abhirathkoushik-cub/ESP32-Solar-BT-Speaker/README.md

# ESP32-Solar-BT-Speaker
This Repository contains the Files and Code for our Pulse Solar Bluetooth Speaker built from a custom 2-layer PCB.
