abhirathkoushik-cub/ESP32-Solar-BT-Speaker/LPEDT_Pulse_FINAL_BOM.xlsx

Comment | Description | Designator | LibRef | Quantity
10uF 25V | Ceramic Capacitor, Ceramic, 25V, 10% +Tol, 10% -Tol, X5R, 15% TC, 10uF, Surface Mount, 0805 | C1, C4, C5, C6, C8, C9, C10, C12, C13, C14, C15, C16, C19, C20, C36 | GRM21BR61E106KA73K | 15 | DONE
0.1 uF 50V | 0.10uF Tol.1%. Rated voltage 50Vdc 125C SMD capacitor C0G(EIA) with capacitance | C2, C3, C7, C11, C26, C27, C29, C31, C33, C34, C35, C39 | GCM31C5C1H104FA16L | 12 | DONE
47nF 16V | CAPACITOR CERAMIC 0.047UF 16V, X7R, 10%, | C17, C21, C37 | CC0603KRX7R7BB473 | 3 | DONE
4.7 uF 25V | Ceramic capacitor SMD 0603 4.7 µF 25 V 10 % (L x W x H) 1.6 x 0.8 x 0.8 mm Murata GRM188R61E475KE11D 4000 pc(s) | C18, C30, C32 | GRM188R61E475KE11D | 3 | DONE
22 uF 16V | 22 µF ±20% 16V Ceramic Capacitor X5R 0603 (1608 Metric) | C22, C23, C24, C25, C28 | CL10A226MO7JZNC | 5 | DONE
1nF 16V | 1000pF ±10% 16V Ceramic Capacitor X7R 0603 (1608 Metric) | C38 | CC0603KRX7R7BB102 | 1 | DONE
SP0503BAHTG | SP050xBA Series 8.5 V 30 pF Triple Uni-Directional TVS Avalanche Diode-SOT143-4 | D1 | SP0503BAHTG | 1
5V ESD |  | D2, D3, D6 | WE-TVS_DFN1610-2L_824032815 | 3 | DONE
6V 2A | No Description Available | F1 | 0ZCJ0200FF2C | 1 | DONE
0.1" M Header | CONN HEADER VERT 2POS 2.54MM | H1, H2, H3, H4, H5 | PRPC002SAAN-RC | 5 | DONE
micro-USB | 10118194-0001LF micro-USB paste-in-pad | J1 | USB-Micro B | 1 | DONE
1uH 7.2A | 1 ÂµH Shielded Molded Inductor 7.2 A 15mOhm Max 1616 (4040 Metric) | L1 | WE-MAPI_4020 | 1 | DONE
1.5uH 9.1A | Description | L2 | ETQ-P3M1R5KVN | 1 | DONE
GRN 0603 | LED, 0603, GREEN, 430MCD, 520NM | LED1, LED2, LED3 | 150060GS75000 | 3 | DONE
SS8050-G | Description | Q1, Q2 | SS8050-G | 2 | DONE
634kΩ | Res Thick Film 0603 634K Ohm 1% 0.1W(1/10W) ±100ppm/C Pad SMD Automotive T/R | R1 | RMCF0603FT634K | 1 | DONE
0 | 0 Ohms Jumper 0.125W, 1/8W Chip Resistor 0603 (1608 Metric) Anti-Sulfur Thin Film | R2, R29, R30, R32, R33, R34, R37, R39, R40, R42, R43, R44 | MCT06030Z0000ZP500 | 12 | PARTIAL
127kΩ | RES 127K OHM 1% 1/10W 0603 | R3 | RMCF0603FT127K | 1 | DONE
100kΩ | RMCF Series 0603 0.1 W 100 kOhm Â±5 % Â±100 ppm/Â°C SMT Thick Film Chip Resistor | R4 | RMCF0603JT100K | 1 | DONE
100Ω | RES 100 OHM 0.1% 1/10W 0603 | R5 | RN73H1JTTD1000B25 | 1 | DONE
2.2kΩ | RES 2.2K OHM 1% 1/10W 0603 | R6, R17, R18 | RN73H1JTTD2201F50 | 3 | DONE
4.7kΩ | Res Thick Film 1.6 x 0.8 mm 4.7K Ohm 1% 0.1W(1/10W) 100ppm/ C Molded SMD Paper T/R | R7, R9 | RC0603FR-074K7L | 2 | DONE
5.23kΩ | 5.23 kOhms ±1% 0.1W, 1/10W Chip Resistor 0603 (1608 Metric) Moisture Resistant Thick Film | R8 | RC0603FR-075K23L | 1 | DONE
10k | 10 kOhms Â±1% 0.125W, 1/8W Chip Resistor 0603 (1608 Metric) Anti-Sulfur, Moisture Resistant Thin Film | R10 | RNCP0603FTD10K0 | 1 | DONE
30.9kΩ | 30,9K 1% 0,1W RC0603 | R11 | RC0603FR-0730K9L | 1 | DONE
1MΩ | 1 MOhms ±5% 0.1W, 1/10W Chip Resistor 0603 (1608 Metric) Automotive AEC-Q200 Thick Film | R12, R13 | RMCF0603JT1M00 | 2 | DONE
180kΩ | 180 kOhms ±1% 0.1W, 1/10W Chip Resistor 0603 (1608 Metric) Automotive AEC-Q200 Thick Film | R14 | RMCF0603FT180K | 1 | DONE
10kΩ | 100mW Thick Film Resistors 75V ±100ppm/℃ ±1% 10kΩ 0603 Chip Resistor - Surface Mount ROHS | R15, R16, R22, R23, R24, R25 | RC0603FR-0710KL | 6 | DONE
1kΩ | Res Thick Film 0603 1K Ohm 1% 0.1W(1/10W) ±100ppm/C Pad SMD T/R Automotive AEC-Q200 | R19 | RMCF0603FT1K00 | 1 | DONE
22.1kΩ | Res Thick Film 0603 22.1K Ohm 1% 0.1W(1/10W) ±100ppm/C Pad SMD Automotive T/R | R20 | RMCF0603FT22K1 | 1 | DONE
47.5kΩ | Res Thick Film 0603 47.5K Ohm 1% 0.1W(1/10W) ±100ppm/C Pad SMD T/R Automotive AEC-Q200 | R21 | RMCF0603FT47K5 | 1 | DONE
3k | 3k ohm | R31 | RMCF0603JT3K00 | 1 | DONE
 | SWITCH TACTILE SPST-NO 0.05A 24V | SW1, SW2, SW3 | 1825910-6 | 3 | DONE
MAX98357A Audio Amplifier | MAX98357A Series 5.5 V 3.2 W PCM Input Class D Audio Power Amplifier - TQFN-16 | U1 | MAX98357AETE+T | 1 | DONE
ESP32-WROOM-32E-N4 | WLAN+BT Module 2412MHz to 2484MHz 47-Pin SMD Module | U2 | ESP32-WROOM-32E-N4 | 1 | DONE
BQ25798RQMR | IÂ²C controlled, 1-4-cell, 5-A buck-boost solar battery charger with dual-input selector and MPPT | U3 | BQ25798RQMR | 1 | DONE
TPS63020DSJR | High Efficiency Single Inductor Buck-Boost Converter with 4A Switch | U4 | TPS63020DSJR | 1 | DONE
CP2102N-A02-GQFN28R | Interface IC full speed USB to UART bridge USB 2.0 3.3V, CP2102N-A02-GQFN24R, VFQFN-24 | U5 | CP2102N-A02-GQFN28R | 1 | DONE
