abhirathkoushik-cub/ESP32-Solar-BT-Speaker/LPEDT_Pulse_FINAL_SCHEMATICS.pdf

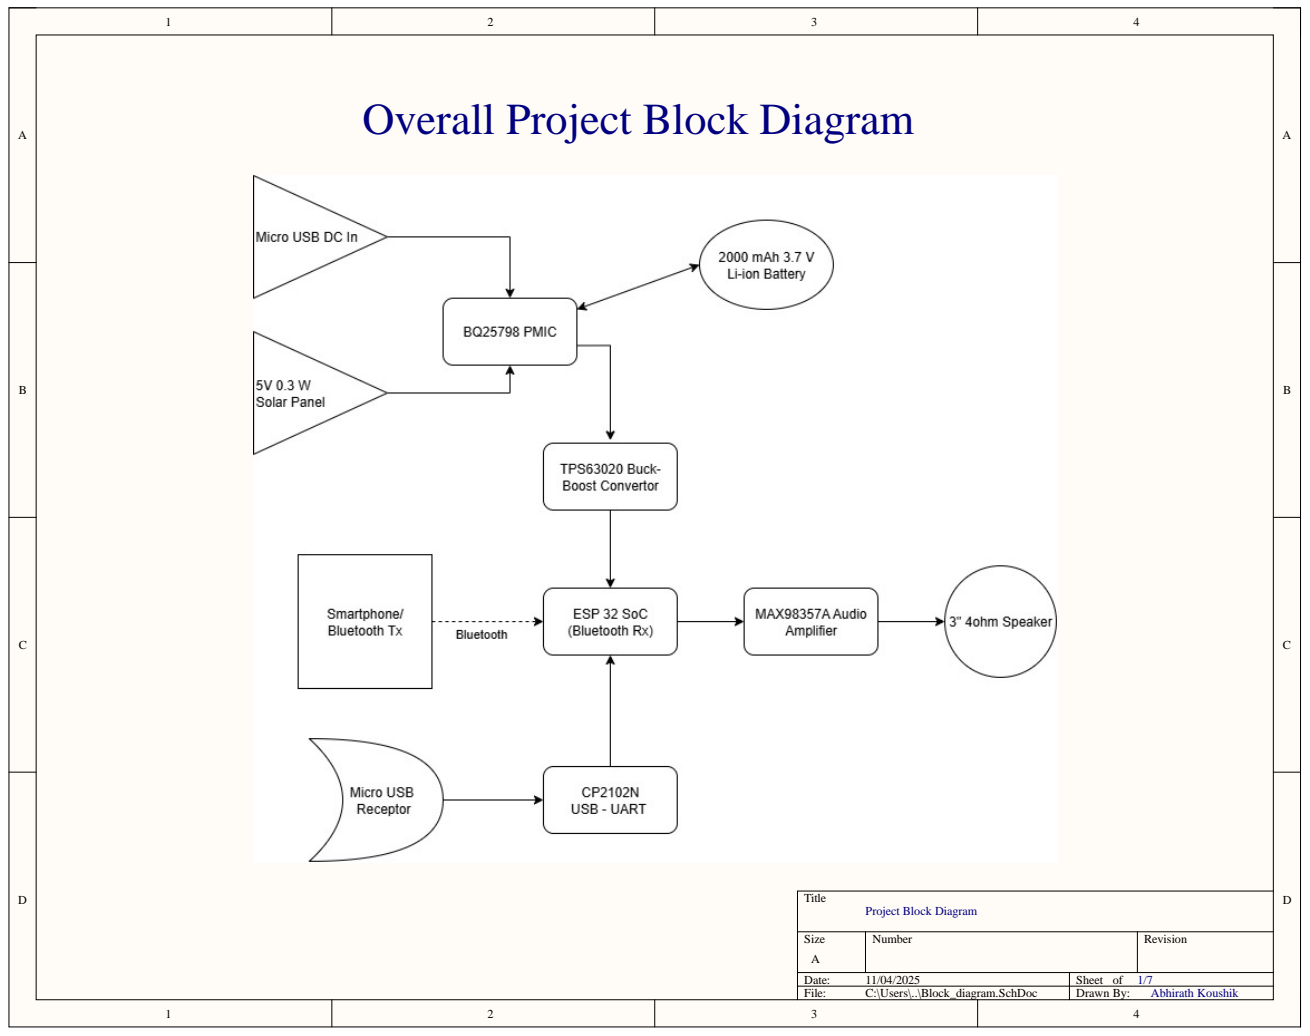
[picture p12: page 1]

Overall Project Block Diagram

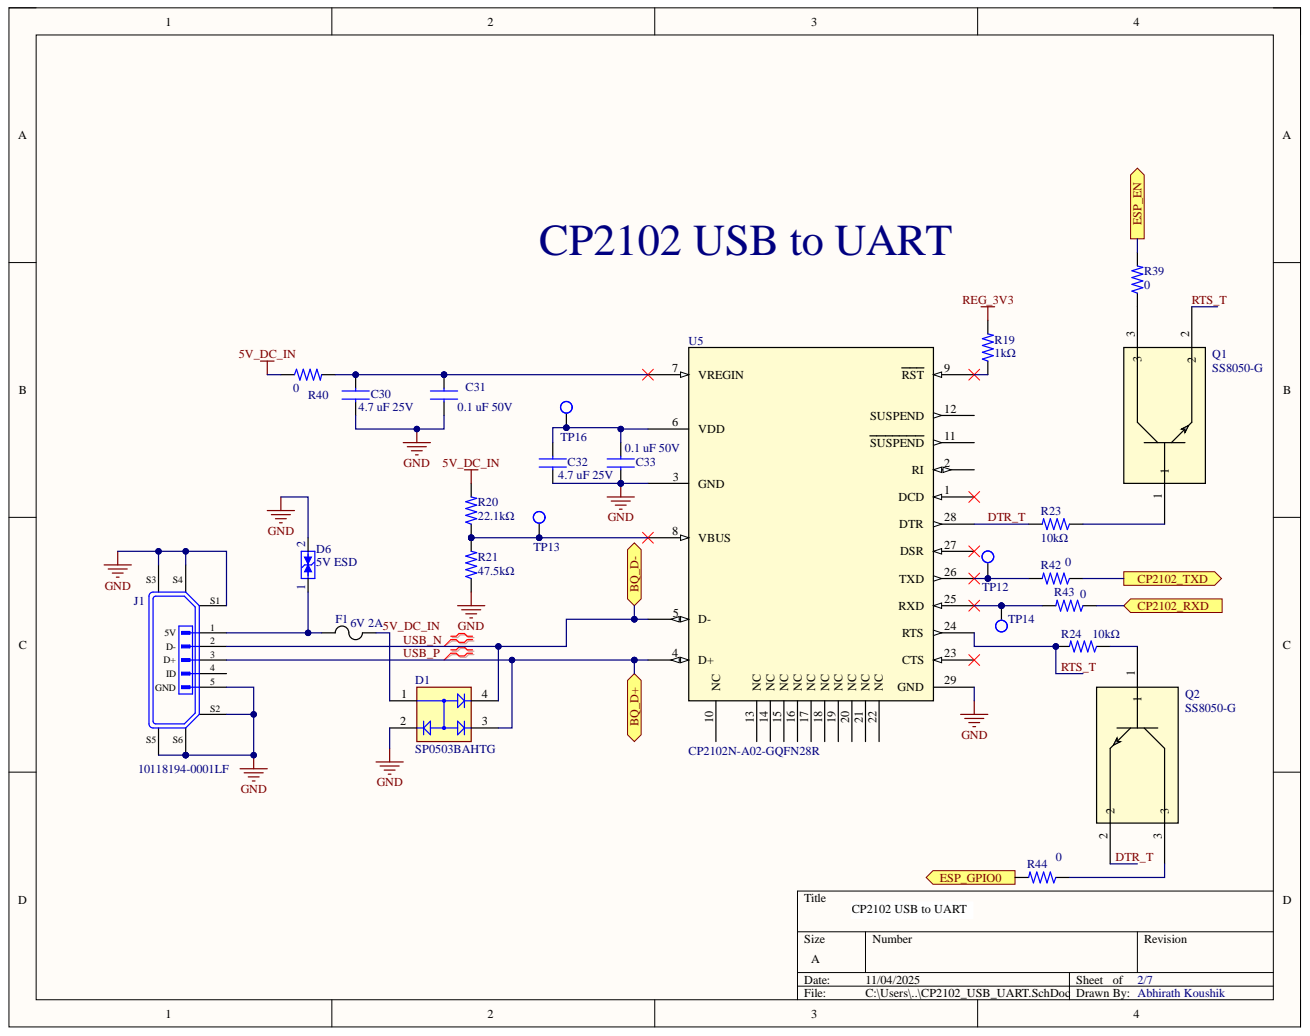
[picture p13: page 2]

4 | D 1

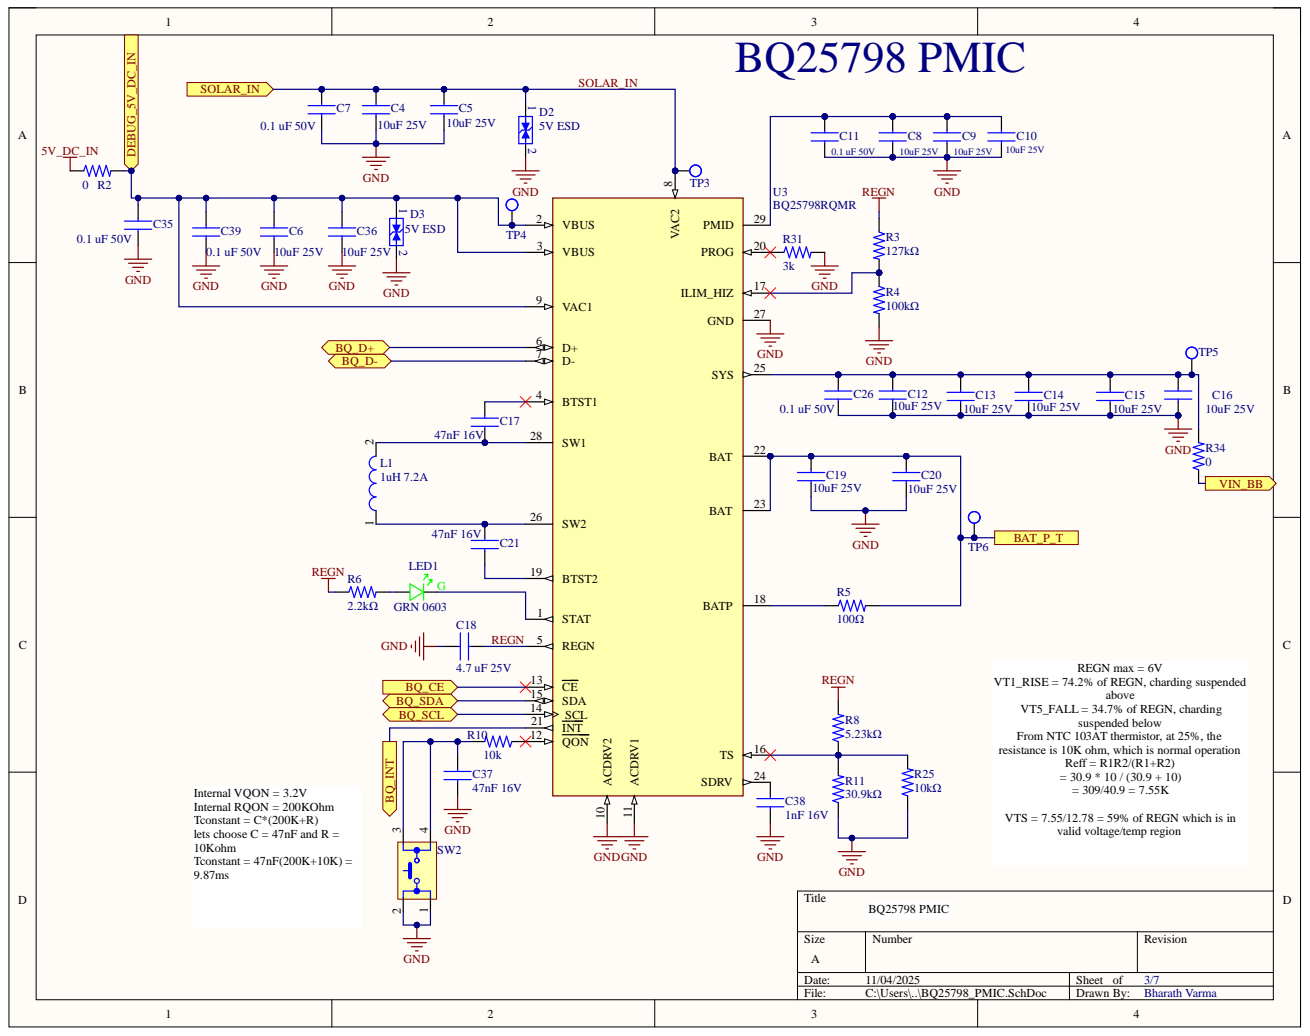
[picture p14: page 3]

VT1_RISE = 74.2% of REGN, charding suspended

From NTC 103AT thermistor, at 25%, the
resistance is 10K ohm, which is normal operation

VTS = 7.55/12.78 = 59% of REGN which is in

valid voltage/temp region

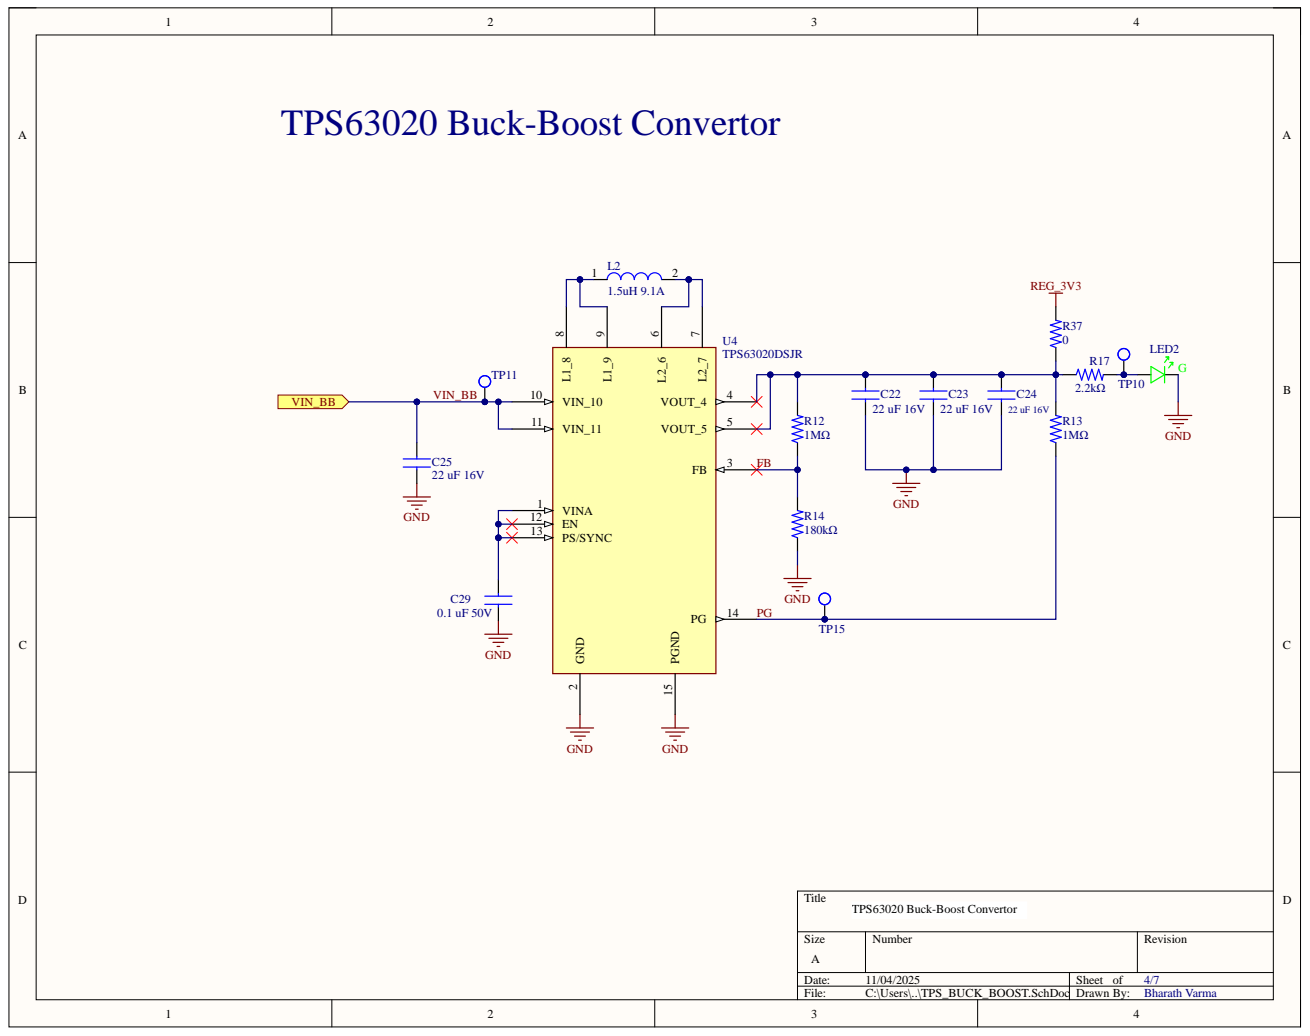
[picture p15: page 4]

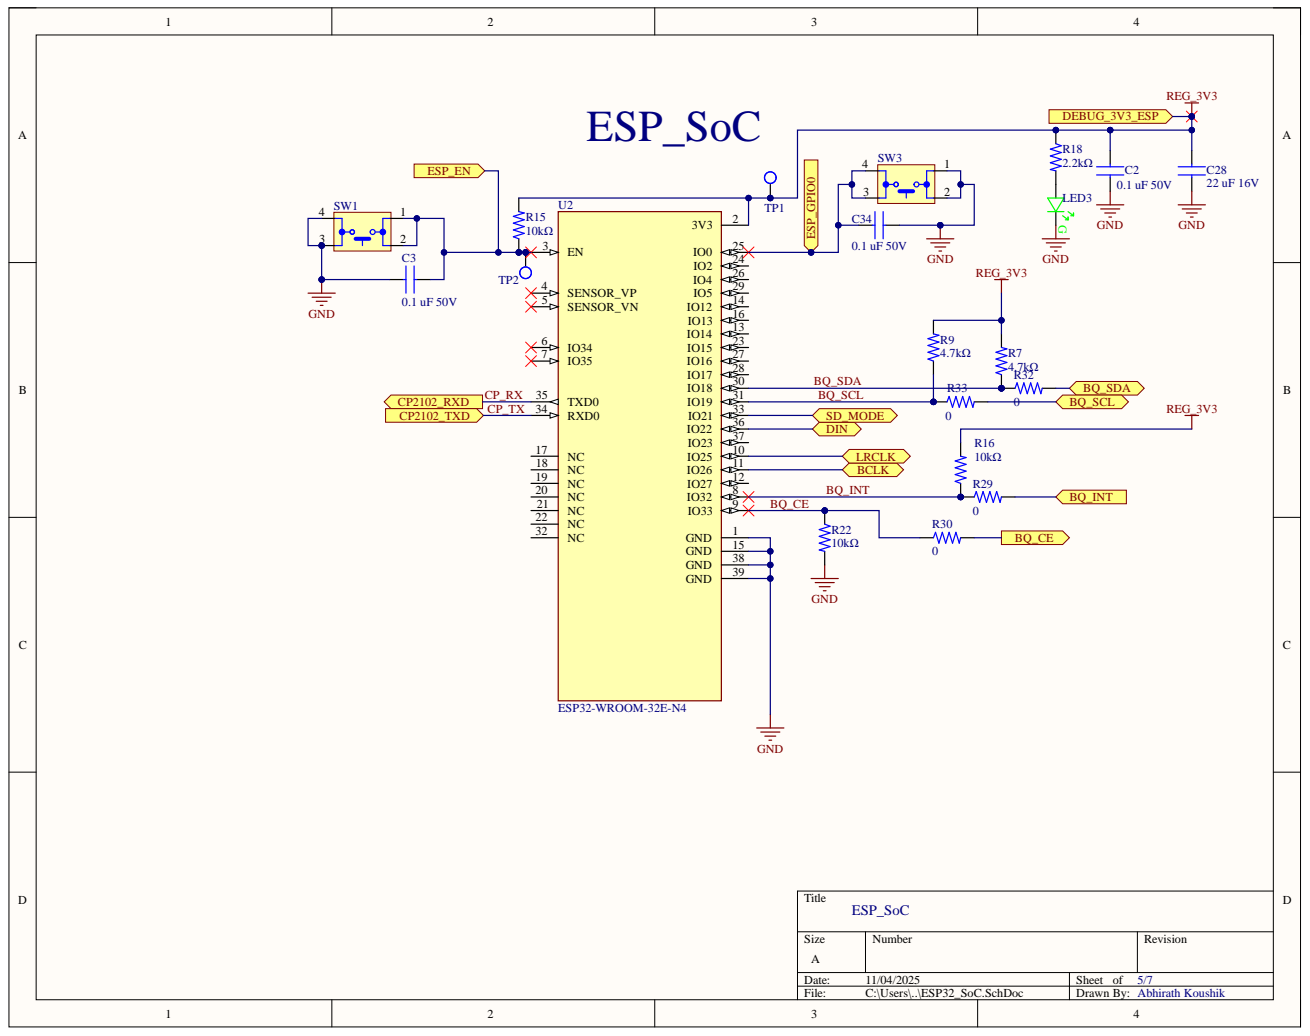
[picture p16: page 5]

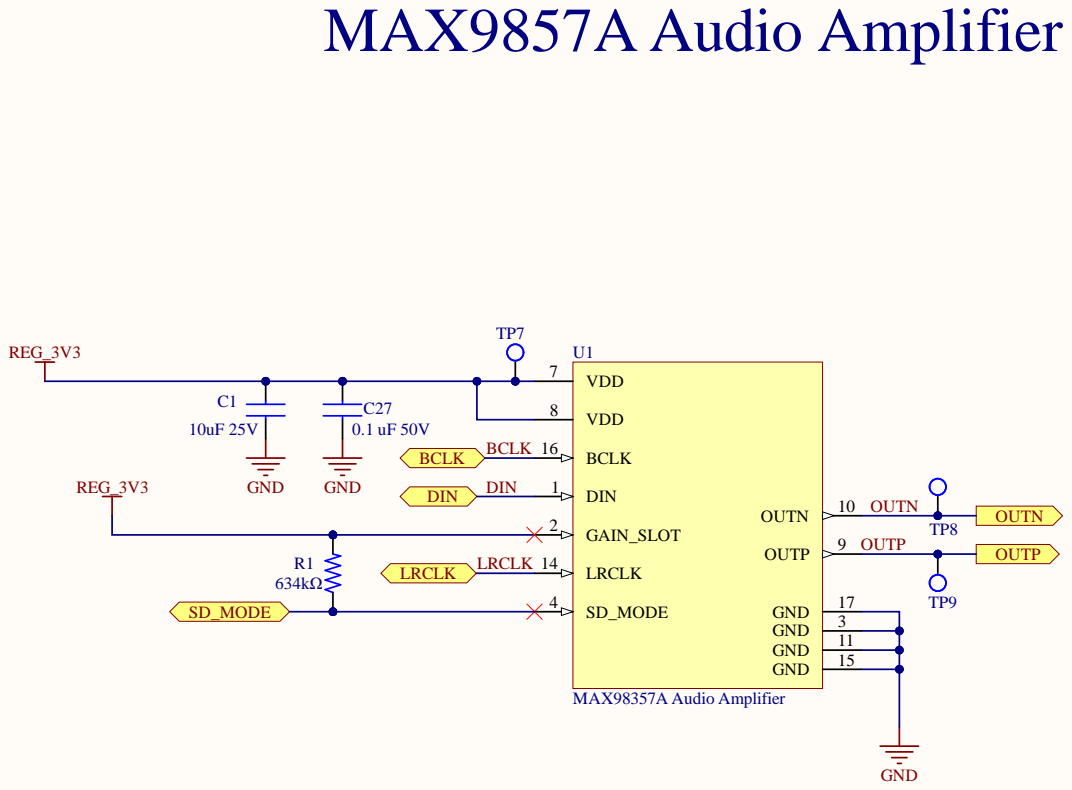
[picture p17: page 6]

MAX9857A Audio Amplifier MAX9857A Audio Ampl

1 1

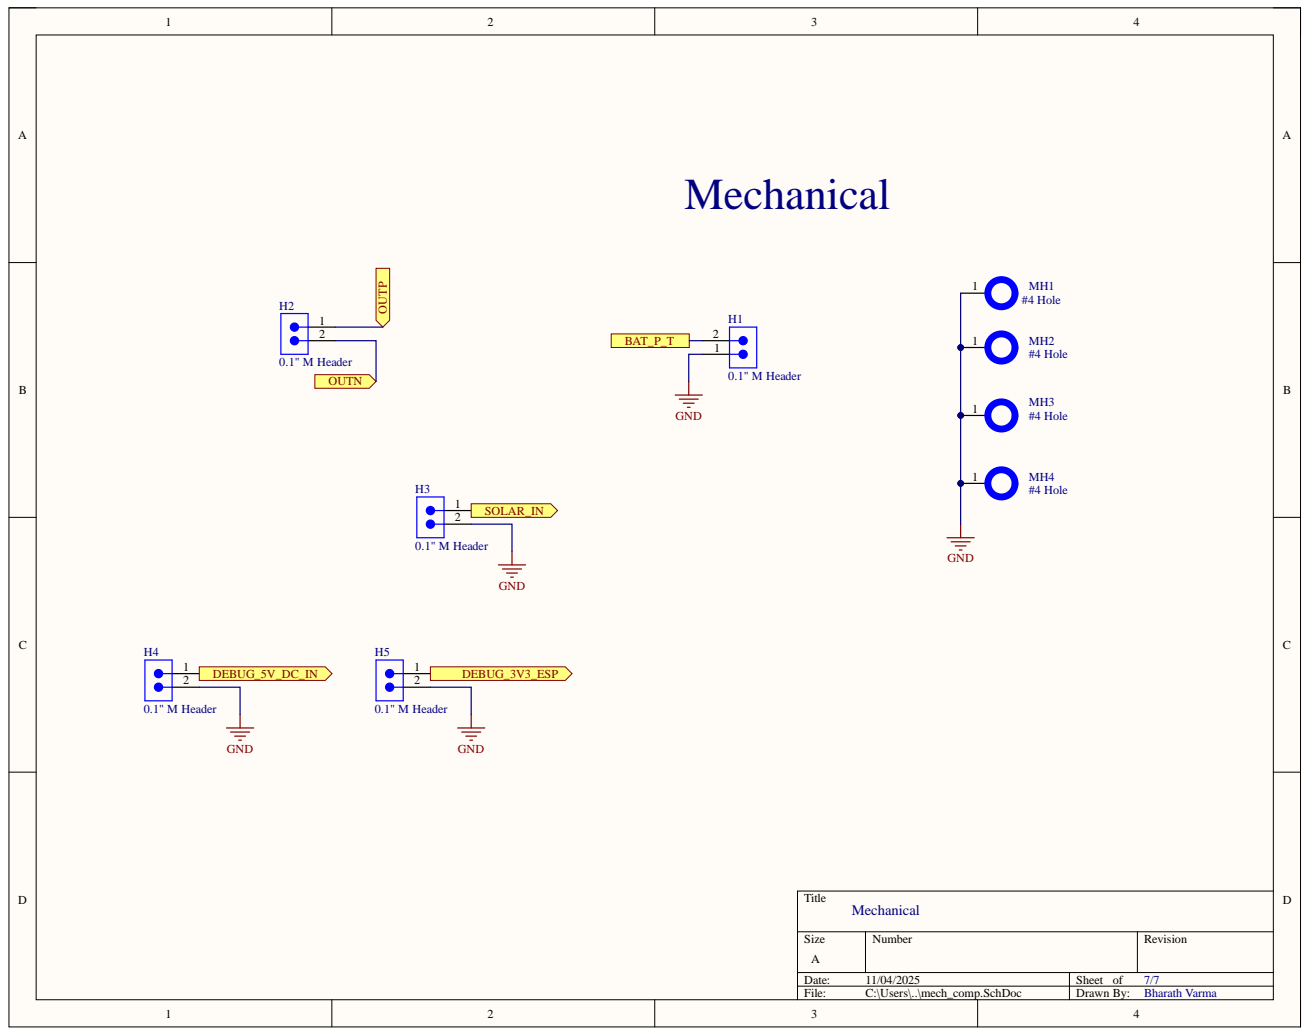
[picture p18: page 7]

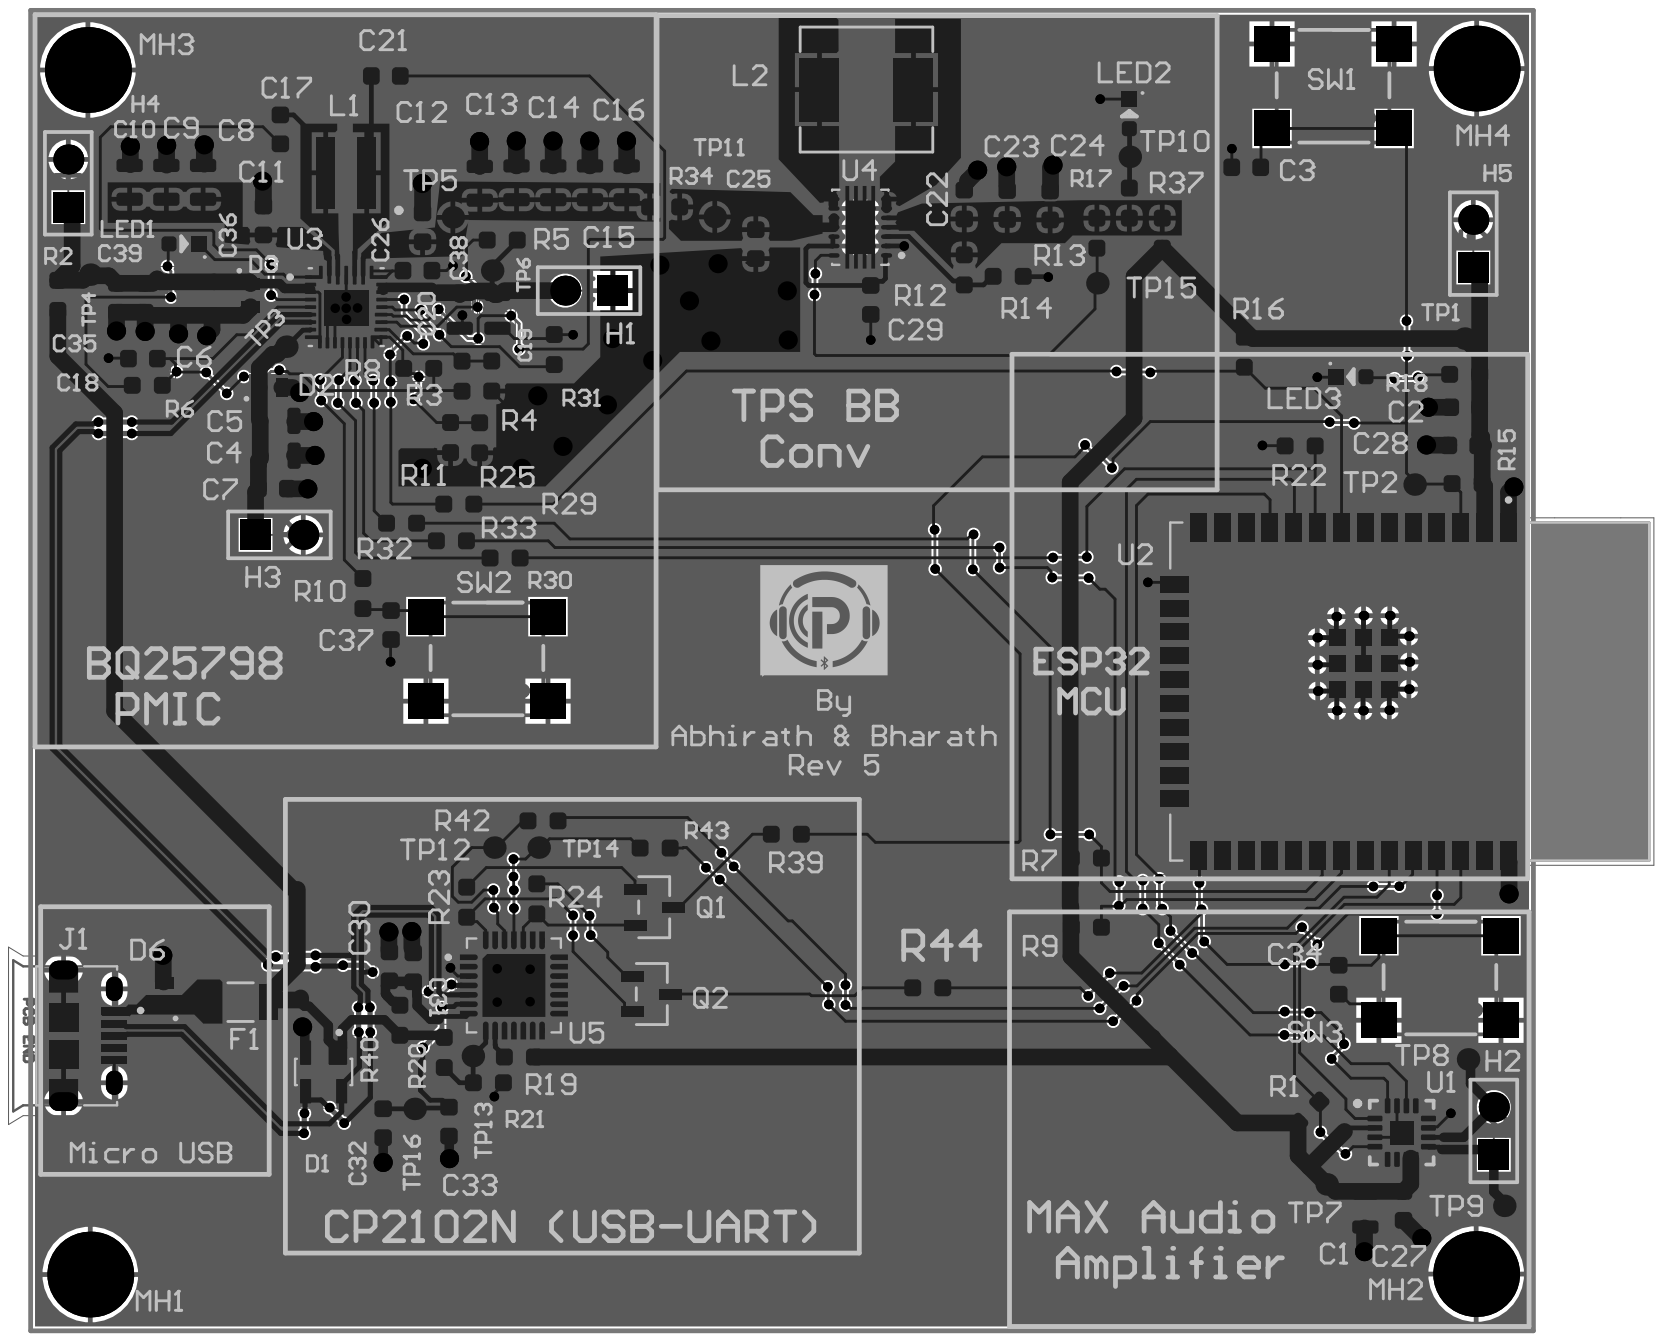
[picture p19: page 8]
