abhirathkoushik-cub/ESP32-Solar-BT-Speaker/(list of files, drawings)

Other design files:
LPEDT_Pulse_PCB_FINAL_SUBMISSION/LPEDT_Pulse_Project/Block_diagram.SchDoc
LPEDT_Pulse_PCB_FINAL_SUBMISSION/LPEDT_Pulse_Project/BQ25798_PMIC.SchDoc
LPEDT_Pulse_PCB_FINAL_SUBMISSION/LPEDT_Pulse_Project/CP2102_USB_UART.SchDoc
LPEDT_Pulse_PCB_FINAL_SUBMISSION/LPEDT_Pulse_Project/ESP32_SoC.SchDoc
LPEDT_Pulse_PCB_FINAL_SUBMISSION/LPEDT_Pulse_Project/LPEDT_Pulse_Project_PCB_FINAL_5.PrjPcb
LPEDT_Pulse_PCB_FINAL_SUBMISSION/LPEDT_Pulse_Project/LPEDT_Pulse_Project_SCH_Library.SchLib
LPEDT_Pulse_PCB_FINAL_SUBMISSION/LPEDT_Pulse_Project/MAX9857A_audio_amp.SchDoc
LPEDT_Pulse_PCB_FINAL_SUBMISSION/LPEDT_Pulse_Project/mech_comp.SchDoc
LPEDT_Pulse_PCB_FINAL_SUBMISSION/LPEDT_Pulse_Project/TPS_BUCK_BOOST.SchDoc
