abhirathkoushik-cub/ESP32-Solar-BT-Speaker/ESP32 and MAX Dev Kit Codes/after_simple_wav_play/my_sound.h

unsigned char ej_actual_song_audacity_wav[] = {
  0x52, 0x49, 0x46, 0x46, 0x44, 0xc6, 0x00, 0x00, 0x57, 0x41, 0x56, 0x45,
  0x66, 0x6d, 0x74, 0x20, 0x10, 0x00, 0x00, 0x00, 0x01, 0x00, 0x01, 0x00,
  0x40, 0x1f, 0x00, 0x00, 0x80, 0x3e, 0x00, 0x00, 0x02, 0x00, 0x10, 0x00,
  0x64, 0x61, 0x74, 0x61, 0x20, 0xc6, 0x00, 0x00, 0xfd, 0xff, 0x02, 0x00,
  0xfb, 0xff, 0x23, 0xfe, 0x6e, 0xfd, 0x81, 0xfe, 0x62, 0xff, 0x77, 0xff,
  0x7d, 0xff, 0x92, 0xff, 0x93, 0xff, 0xa5, 0xff, 0xa6, 0xff, 0xb7, 0xff,
  0xb5, 0xff, 0xc5, 0xff, 0xc1, 0xff, 0xcf, 0xff, 0xcf, 0xff, 0xd5, 0xff,
  0xda, 0xff, 0xdc, 0xff, 0xde, 0xff, 0xe6, 0xff, 0xe3, 0xff, 0xeb, 0xff,
  0xe9, 0xff, 0xeb, 0xff, 0xf0, 0xff, 0xee, 0xff, 0xf4, 0xff, 0xf0, 0xff,
  0xf7, 0xff, 0xf1, 0xff, 0xfb, 0xff, 0xf2, 0xff, 0xfd, 0xff, 0xf3, 0xff,
  0x01, 0x00, 0xef, 0xff, 0x0a, 0x00, 0xe5, 0xff, 0x1f, 0x00, 0x3f, 0xff,
  0xe1, 0xfd, 0xba, 0xfe, 0x8e, 0xff, 0xbd, 0xff, 0x65, 0xfe, 0xc8, 0xfc,
  0x91, 0xfd, 0x0d, 0x00, 0x62, 0x01, 0x91, 0xff, 0xca, 0xff, 0x4b, 0x01,
  0x41, 0x02, 0x89, 0x02, 0x01, 0x01, 0x5b, 0xff, 0xa2, 0xff, 0xf6, 0xff,
  0xf2, 0xfe, 0x04, 0xff, 0x6d, 0xfe, 0xfe, 0xff, 0x35, 0x02, 0xc7, 0x02,
  0xf1, 0x00, 0xe8, 0xfe, 0x13, 0x00, 0xfe, 0x00, 0x44, 0x00, 0x57, 0xff,
  0x6d, 0xff, 0xfb, 0xff, 0xef, 0xff, 0x70, 0xfd, 0xb9, 0xfb, 0xad, 0xfd,
  0xc9, 0x00, 0x42, 0x00, 0x87, 0xfd, 0x3b, 0xfe, 0xb8, 0xff, 0x50, 0xff,
  0x73, 0xfe, 0x8f, 0xfc, 0x0c, 0xfc, 0x04, 0xfe, 0x68, 0xfe, 0x1f, 0xfd,
  0x58, 0xfc, 0x04, 0xfe, 0x51, 0x01, 0x50, 0x02, 0x0c, 0x01, 0x76, 0xff,
  0x99, 0xff, 0x1d, 0x02, 0x65, 0x02, 0xdb, 0x00, 0x4a, 0x01, 0x27, 0x02,
  0x22, 0x03, 0x9f, 0x01, 0x2b, 0xff, 0xb1, 0xff, 0xe0, 0x01, 0x9c, 0x02,
  0xa6, 0x01, 0x99, 0x01, 0x69, 0x01, 0x8b, 0x01, 0x8e, 0x01, 0x08, 0x00,
  0x2c, 0xfe, 0xc0, 0xfe, 0xc2, 0x00, 0x67, 0xff, 0x75, 0xfe, 0x46, 0xff,
  0x54, 0x00, 0x46, 0x01, 0x27, 0x01, 0x63, 0x00, 0x99, 0xff, 0x2e, 0x00,
  0xa2, 0x00, 0x3f, 0x00, 0x22, 0xff, 0x79, 0xff, 0x97, 0x00, 0x73, 0x00,
  0xca, 0x00, 0xcf, 0xff, 0x16, 0xff, 0xd2, 0xff, 0x58, 0x00, 0xf8, 0xff,
  0xd2, 0xff, 0x16, 0x01, 0x0f, 0x02, 0xbb, 0x02, 0x44, 0x02, 0xe7, 0x00,
  0x19, 0x01, 0xad, 0x01, 0x85, 0x01, 0x4b, 0x00, 0x56, 0x00, 0x0d, 0x02,
  0xee, 0x01, 0x3b, 0x02, 0xee, 0x00, 0xa5, 0xff, 0xe2, 0x00, 0x20, 0x02,
  0xa8, 0x01, 0x3a, 0x00, 0xc3, 0xfe, 0x98, 0x00, 0xb2, 0x02, 0x7b, 0x01,
  0xcf, 0xfe, 0xc1, 0xfd, 0xd7, 0xff, 0x4d, 0xff, 0xa9, 0xfe, 0xe1, 0xfd,
  0x2b, 0xfe, 0xc9, 0xfd, 0xeb, 0xfd, 0xbf, 0xfe, 0xa5, 0x00, 0xfb, 0xff,
  0xe3, 0xff, 0xa2, 0x00, 0xab, 0xfe, 0x81, 0xff, 0x9c, 0xff, 0x7c, 0x00,
  0x6c, 0x00, 0xb5, 0xfe, 0xd1, 0xfe, 0x88, 0x01, 0x85, 0x02, 0xee, 0x00,
  0xc9, 0xfe, 0xb1, 0x00, 0x63, 0x02, 0x7e, 0x01, 0xd0, 0xfe, 0xa8, 0xfc,
  0xce, 0xfe, 0xd5, 0x00, 0x78, 0x00, 0x8e, 0xfe, 0xb4, 0xfe, 0x94, 0xff,
  0xbd, 0x00, 0xfa, 0xfe, 0x63, 0xfc, 0x82, 0xfc, 0x9f, 0xff, 0xa9, 0x01,
  0x43, 0x00, 0x53, 0xff, 0x1d, 0xff, 0xac, 0xff, 0x74, 0xff, 0x1d, 0xfe,
  0x6a, 0xfd, 0x5f, 0xfe, 0x76, 0x00, 0xee, 0xff, 0x0e, 0xff, 0xfb, 0xff,
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
};
unsigned int ej_actual_song_audacity_wav_len = 50764;
