abhirathkoushik-cub/ESP32-Solar-BT-Speaker/(commit log)

2025-11-04 adding pcb fab submission files with final sch and bom
    [BQ25798_PMIC.SchDoc, Block_diagram.SchDoc, CP2102_USB_UART.SchDoc, ESP32_SoC.SchDoc, LPEDT_Pulse_FINAL_BOM.xlsx, LPEDT_Pulse_Project_PCB_FINAL_5.PrjPcb, LPEDT_Pulse_Project_PCB_FINAL_5.xlsx, LPEDT_Pulse_Project_SCH_Library.SchLib]
2025-11-25 updated BOM with assembly status, initial bluetooth audio code on PCB
    [LPEDT_Pulse_FINAL_BOM.xlsx]
2025-11-26 Added I2C code
2025-11-26 minor change in sda/scl pins in Wire begin
2025-11-26 updated battery metrics and modularized code
2025-11-29 adding power mngt code for active and deep sleep states
2025-12-04 minor changes in i2c and deep sleep timings and added Presentation
